cansat-tsniimash/cansat-atlaspp-2022-2023/readme.md

Репозитий команды АТЛАС++ на 2022-2023 года
