cansat-tsniimash/cansat-atlaspp-2022-2023/scheme/projects/Альфа/Alfa_b.brd

## EAGLE design scheme/projects/Альфа/Alfa_b.brd (2023-02-11)

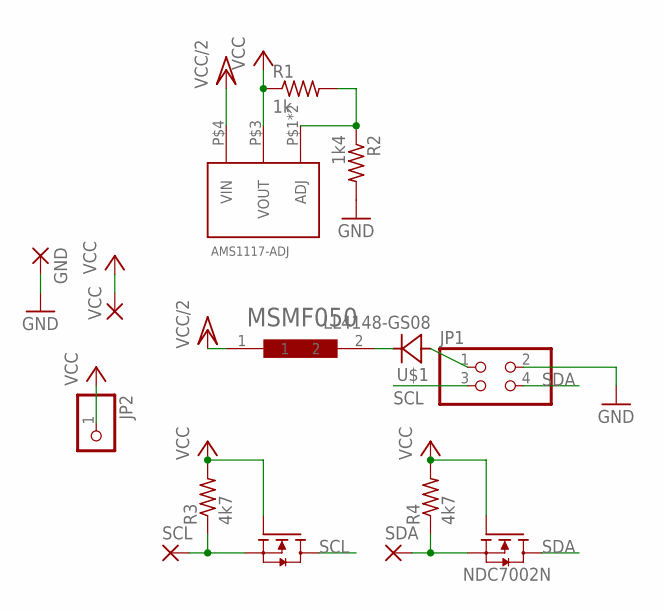
[picture p1: schematic Alfa_b.sch]

Parts:
AMS1117-ADJ: AMS1117; SOT223
GND: SMD2; SMD1,27-2,54
JP1: PINHD-2X2; 2X02
JP2: PINHD-1X1; 1X01
MSMF050: MF-MSMF050
NDC7002N: NDC7002N; SOT-23-6
R1: 1k; R0603
R2: 1k4; R0603
R3, R4: 4k7; R0603
SCL: SMD2; SMD1,27-2,54
SDA: SMD2; SMD1,27-2,54
U$1: LL4148-GS08; SOD-80
VCC: SMD2; SMD1,27-2,54

Connections:
GND: GND.1, JP1.2, R2.2
unnamed: MSMF050.2, U$1.2 (C)
unnamed: JP1.1, U$1.1 (A)
unnamed: AMS1117-ADJ.P$1 (ADJ), AMS1117-ADJ.P$2 (ADJ), R1.2, R2.1
unnamed: NDC7002N.5 (S1), R3.1, SCL.1
unnamed: NDC7002N.2 (S2), R4.1, SDA.1
SCL: JP1.3, NDC7002N.6 (D1)
SDA: JP1.4, NDC7002N.4 (D2)
VCC: AMS1117-ADJ.P$3 (VOUT), JP2.1, NDC7002N.1 (G1), NDC7002N.3 (G2), R1.1, R3.2, R4.2, VCC.1
VCC/2: AMS1117-ADJ.P$4 (VIN), MSMF050.1

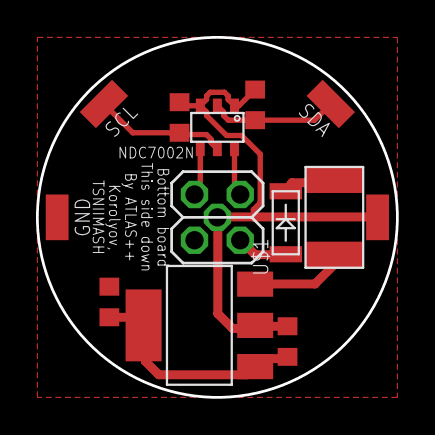
[picture p2: board Alfa_b.brd from above]

Board: 2 copper layers, 20.0 x 20.0 mm, 14 parts (1 on the bottom side), 10 nets.
