cansat-tsniimash/cansat-atlaspp-2022-2023/scheme/projects/Бета/Beta.brd

## EAGLE design scheme/projects/Бета/Beta.brd (2023-02-11)

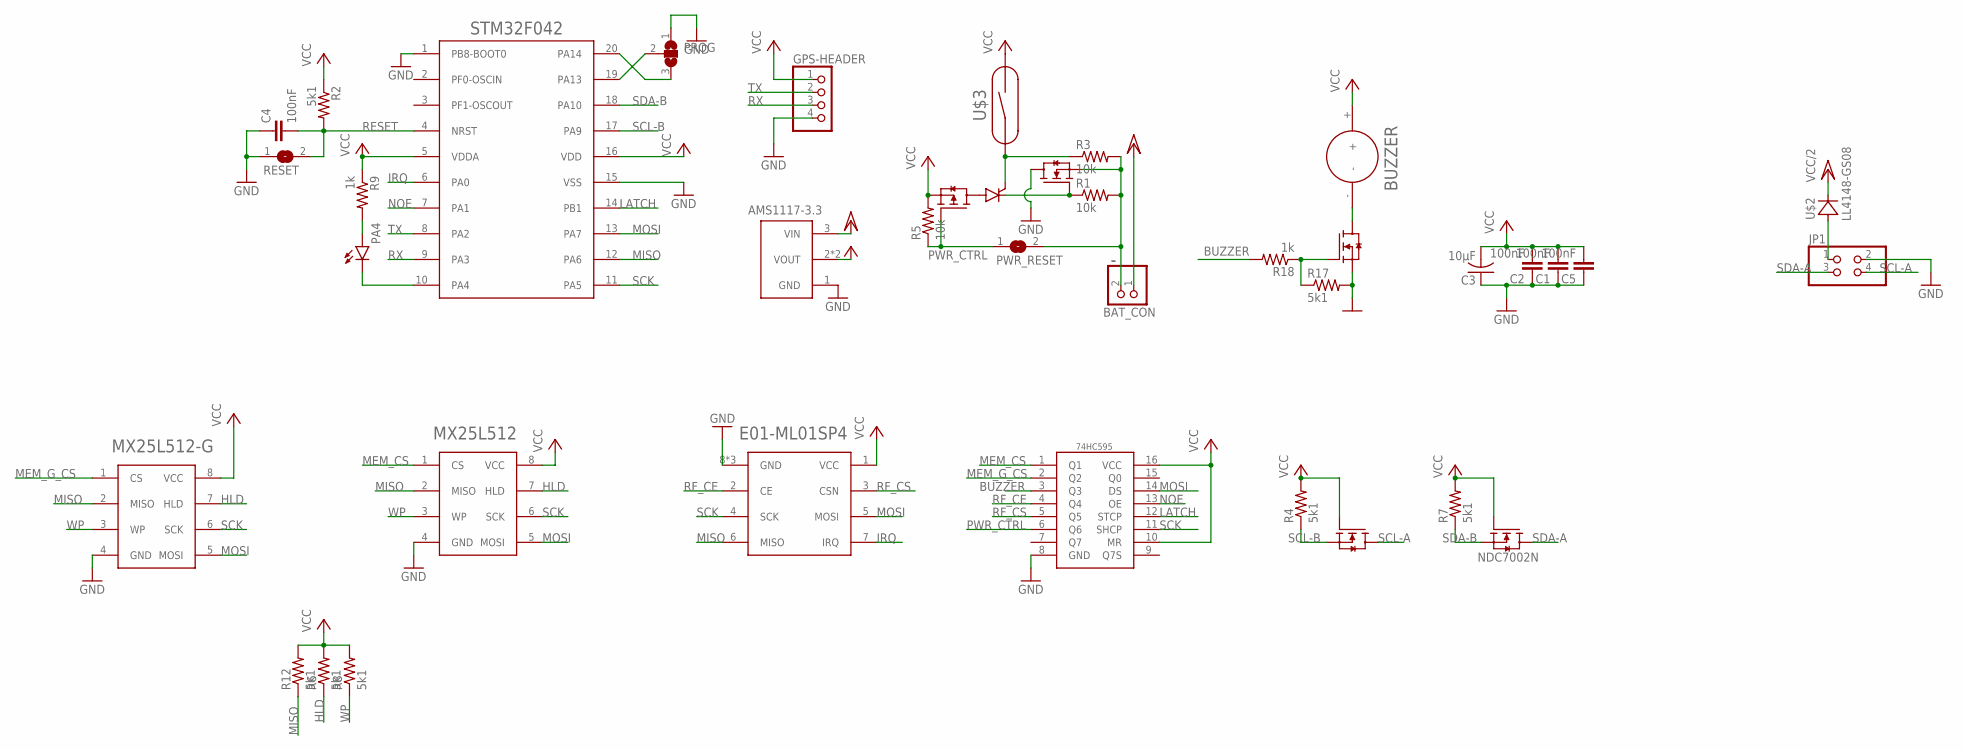
[picture p3: schematic Beta.sch]

Parts:
74HC595: 74HC595SOIC16; SOIC16
AMS1117-3.3: AMS1117; SOT223
AO3407: AO3407A; SOT23-3
BAT_CON: PINHD-1X2; 1X02
BUZ: SI2302CDS; SOT23-3
BUZZER: BUZZER-5V; BUZZER
C1, C2, C4, C5: 100nF; C0603
C3: 10µF; C1206
E01-ML01SP4: E01-ML01SP4
GPS-HEADER: PINHD-1X4; 1X04
JP1: PINHD-2X2; 2X02
MX25L512, MX25L512-G: MX25L25645; SOP8
NDC7002N: NDC7002N; SOT-23-6
P0102BL: P0102BL; SOT23-3
PA4: LEDCHIPLED_0603; CHIPLED_0603
PROG: SJ2W; SJ_2
PWR_RESET: SJ
R1, R3, R5: 10k; R0603
R2, R4, R6, R7, R8, R12, R17: 5k1; R0603
R9, R18: 1k; R0603
RESET: SJ
SI2302: SI2302CDS; SOT23-3
STM32F042: STM32F042F6P6; TSSOP-20
U$2: LL4148-GS08; SOD-80
U$3: МКА-07101

Connections:
BUZZER: 74HC595.3 (Q3), R18.2
GND: 74HC595.8 (GND), AMS1117-3.3.1 (GND), BUZ.2 (S), C1.1, C2.1, C3.1, C4.1, C5.1, E01-ML01SP4.8 (GND), E01-ML01SP4.9 (GND), E01-ML01SP4.10 (GND), GPS-HEADER.4, JP1.2, MX25L512.4 (GND), MX25L512-G.4 (GND), PROG.1, R17.2, RESET.1, SI2302.3 (D), STM32F042.1 (PB8-BOOT0), STM32F042.15 (VSS)
GND1: PA4.C, STM32F042.10 (PA4)
HLD: MX25L512.7 (HLD), MX25L512-G.7 (HLD), R6.1
IRQ: E01-ML01SP4.7 (IRQ), STM32F042.6 (PA0)
LATCH: 74HC595.12 (STCP), STM32F042.14 (PB1)
MEM_CS: 74HC595.1 (Q1), MX25L512.1 (CS)
MEM_G_CS: 74HC595.2 (Q2), MX25L512-G.1 (CS)
MISO: E01-ML01SP4.6 (MISO), MX25L512.2 (MISO), MX25L512-G.2 (MISO), R12.1, STM32F042.12 (PA6)
MOSI: 74HC595.14 (DS), E01-ML01SP4.5 (MOSI), MX25L512.5 (MOSI), MX25L512-G.5 (MOSI), STM32F042.13 (PA7)
unnamed: BUZ.3 (D), BUZZER.-
unnamed: PROG.2, STM32F042.19 (PA13)
unnamed: PROG.3, STM32F042.20 (PA14)
unnamed: P0102BL.1 (C), R1.1, SI2302.1 (G)
unnamed: PA4.A, R9.2
unnamed: P0102BL.2 (G), R3.1, U$3.1
unnamed: AO3407.3 (D), P0102BL.3 (A)
unnamed: BAT_CON.2, PWR_RESET.2, R1.2, R3.2, SI2302.2 (S)
unnamed: BUZ.1 (G), R17.1, R18.1
unnamed: JP1.1, U$2.1 (A)
NOE: 74HC595.13 (OE), STM32F042.7 (PA1)
PWR_CTRL: 74HC595.6 (Q6), AO3407.1 (G), PWR_RESET.1, R5.1
RESET: C4.2, R2.2, RESET.2, STM32F042.4 (NRST)
RF_CE: 74HC595.4 (Q4), E01-ML01SP4.2 (CE)
RF_CS: 74HC595.5 (Q5), E01-ML01SP4.3 (CSN)
RX: GPS-HEADER.3, STM32F042.9 (PA3)
SCK: 74HC595.11 (SHCP), E01-ML01SP4.4 (SCK), MX25L512.6 (SCK), MX25L512-G.6 (SCK), STM32F042.11 (PA5)
SCL-A: JP1.4, NDC7002N.6 (D1)
SCL-B: NDC7002N.5 (S1), R4.1, STM32F042.17 (PA9)
SDA-A: JP1.3, NDC7002N.4 (D2)
SDA-B: NDC7002N.2 (S2), R7.1, STM32F042.18 (PA10)
TX: GPS-HEADER.2, STM32F042.8 (PA2)
VCC: 74HC595.10 (MR), 74HC595.16 (VCC), AMS1117-3.3.2 (VOUT), AMS1117-3.3.4 (VOUT), AO3407.2 (S), BUZZER.+, C1.2, C2.2, C3.2, C5.2, E01-ML01SP4.1 (VCC), GPS-HEADER.1, MX25L512.8 (VCC), MX25L512-G.8 (VCC), NDC7002N.1 (G1), NDC7002N.3 (G2), R2.1, R4.2, R5.2, R6.2, R7.2, R8.2, R9.1, R12.2, STM32F042.5 (VDDA), STM32F042.16 (VDD), U$3.2
VCC/2: AMS1117-3.3.3 (VIN), BAT_CON.1, U$2.2 (C)
WP: MX25L512.3 (WP), MX25L512-G.3 (WP), R8.1

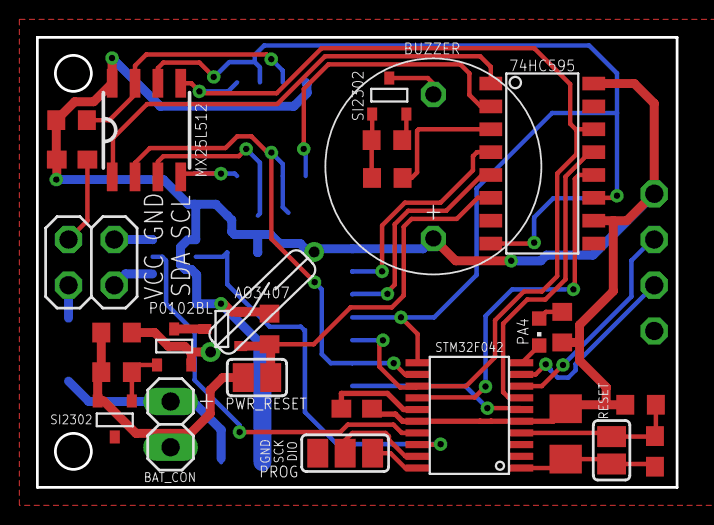
[picture p4: board Beta.brd from above]

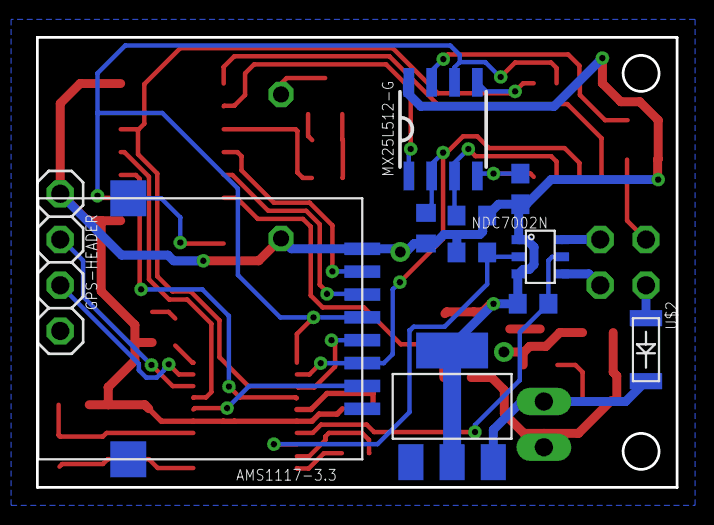
[picture p5: board Beta.brd from below]

Board: 2 copper layers, 35.5 x 25.0 mm, 38 parts (11 on the bottom side), 35 nets.
