cansat-tsniimash/cansat-atlaspp-2022-2023/scheme/projects/Альфа/Alfa_t.brd

## EAGLE design scheme/projects/Альфа/Alfa_t.brd (2023-02-11)

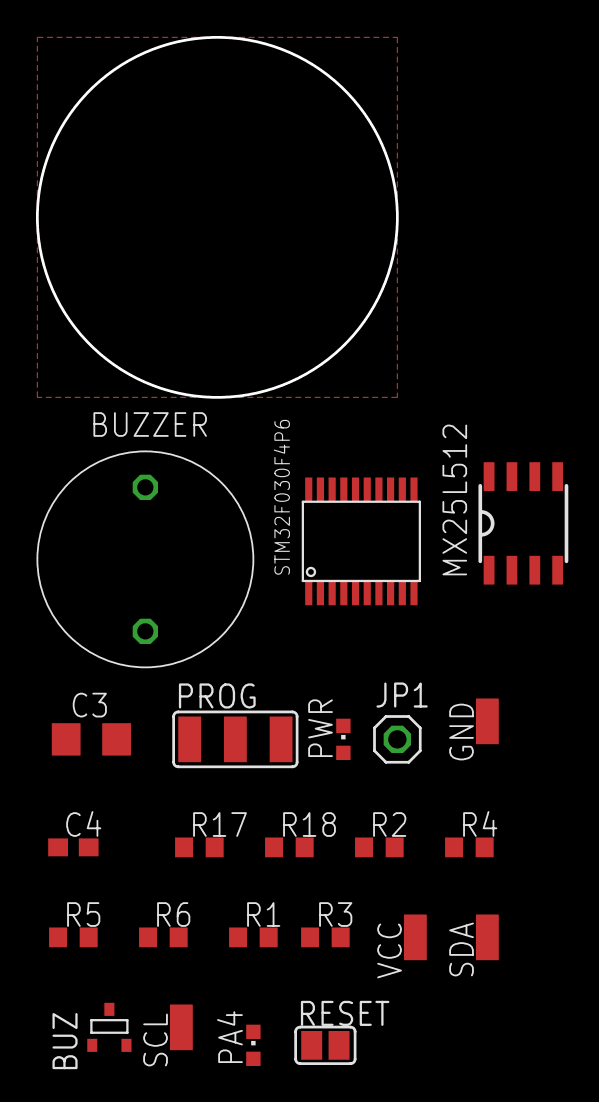
[picture p6: board Alfa_t.brd from above]

Board: 2 copper layers, 20.0 x 20.0 mm, 23 parts (0 on the bottom side), 21 nets, no tracks yet.

Parts:
BUZ: SI2302CDS; SOT23-3
BUZZER: BUZZER-5V; BUZZER
C3: 10µF; C1206
C4: 100nF; C0603
GND: SMD1,27-2,54
JP1: 1X01
MX25L512: MX25L25645; SOP8
PA4: CHIPLED_0603
PROG: SJ_2W
PWR: CHIPLED_0603
R1, R3, R18: 1k; R0603
R2, R4, R5, R6, R17: 5k1; R0603
RESET: SJ
SCL: SMD1,27-2,54
SDA: SMD1,27-2,54
STM32F030F4P6: STM32F030F4P6; TSSOP-20
VCC: SMD1,27-2,54

Connections:
BUZZER: R18.2, STM32F030F4P6.9
CS: MX25L512.1, STM32F030F4P6.14
GND: BUZ.2, C3.1, C4.1, GND.1, MX25L512.4, PROG.3, PWR.C, R17.2, RESET.1, STM32F030F4P6.1, STM32F030F4P6.15
MISO: MX25L512.2, STM32F030F4P6.12
MOSI: R4.2, STM32F030F4P6.13
unnamed: BUZ.3, BUZZER.-
unnamed: PROG.2, STM32F030F4P6.20
unnamed: PROG.1, STM32F030F4P6.19
unnamed: PWR.A, R3.2
unnamed: PA4.A, R1.2
unnamed: PA4.C, STM32F030F4P6.10
unnamed: JP1.1, STM32F030F4P6.8
unnamed: MX25L512.3, R5.1
unnamed: BUZ.1, R17.1, R18.1
unnamed: MX25L512.5, R4.1
unnamed: MX25L512.7, R6.1
RESET: C4.2, R2.2, RESET.2, STM32F030F4P6.4
SCK: MX25L512.6, STM32F030F4P6.11
SCL: SCL.1, STM32F030F4P6.17
SDA: SDA.1, STM32F030F4P6.18
VCC: BUZZER.+, C3.2, MX25L512.8, R1.1, R2.1, R3.1, R5.2, R6.2, STM32F030F4P6.5, STM32F030F4P6.16, VCC.1
