cansat-tsniimash/cansat-atlaspp-2022-2023/scheme/projects/Альфа/Alfa_m.brd

## EAGLE design scheme/projects/Альфа/Alfa_m.brd (2023-02-11)

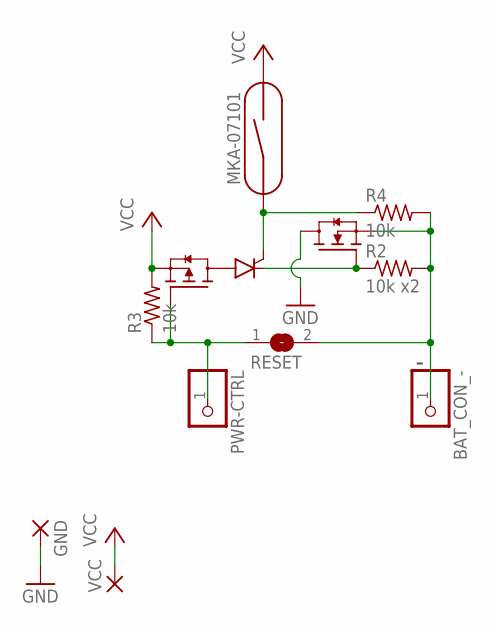
[picture p7: schematic Alfa_m.sch]

Parts:
AO3407: AO3407A; SOT23-3
BAT_CON_-: PINHD-1X1; 1X01
GND: SMD2; SMD1,27-2,54
P0102BL: P0102BL; SOT23-3
PWR-CTRL: PINHD-1X1; 1X01
R2: 10k x2; R0603
R3, R4: 10k; R0603
RESET: SJ
SI2302: SI2302CDS; SOT23-3
VCC: SMD2; SMD1,27-2,54
МКА-07101: МКА-07101

Connections:
GND: GND.1, SI2302.3 (D)
unnamed: P0102BL.1 (C), R2.1, SI2302.1 (G)
unnamed: P0102BL.2 (G), R4.1, МКА-07101.1
unnamed: AO3407.3 (D), P0102BL.3 (A)
unnamed: BAT_CON_-.1, R2.2, R4.2, RESET.2, SI2302.2 (S)
unnamed: AO3407.1 (G), PWR-CTRL.1, R3.1, RESET.1
VCC: AO3407.2 (S), R3.2, VCC.1, МКА-07101.2

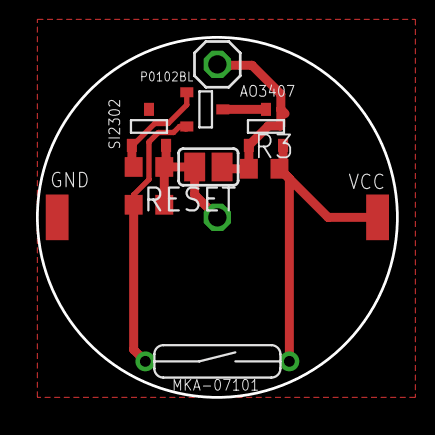
[picture p8: board Alfa_m.brd from above]

Board: 2 copper layers, 20.0 x 20.0 mm, 12 parts (1 on the bottom side), 7 nets.
