cansat-tsniimash/cansat-atlaspp-2022-2023/src/board/Cerberus/Cerberus.ioc

Mcu.UserName=STM32F401RCTx
PA13.Signal=SYS_JTMS-SWDIO
PA14.Signal=SYS_JTCK-SWCLK
PA4.Signal=ADCx_IN4
PA5.Signal=GPIO_Input
PB13.Signal=SPI2_SCK
PB14.Signal=SPI2_MISO
PB15.Signal=SPI2_MOSI
PB6.Signal=I2C1_SCL
PB7.Signal=I2C1_SDA
PC1.GPIO_Label=latch
PC1.Signal=GPIO_Output
PC10.Signal=SDIO_D2
PC11.Signal=SDIO_D3
PC12.Signal=SDIO_CK
PC13-ANTI_TAMP.GPIO_Label=oe
PC13-ANTI_TAMP.Signal=GPIO_Output
PC14-OSC32_IN.Signal=RCC_OSC32_IN
PC15-OSC32_OUT.Signal=RCC_OSC32_OUT
PC2.Signal=GPIO_Input
PC4.Signal=GPIO_Output
PC5.Signal=GPIO_Output
PC6.Signal=USART6_TX
PC7.Signal=USART6_RX
PC8.Signal=SDIO_D0
PC9.Signal=SDIO_D1
PD2.Signal=SDIO_CMD
