cansat-tsniimash/cansat-atlaspp-2022-2023/src/board/Cerberus/Core/Inc/main.h

#define oe_Pin GPIO_PIN_13
#define oe_GPIO_Port GPIOC
#define latch_Pin GPIO_PIN_1
#define latch_GPIO_Port GPIOC
