cansat-tsniimash/cansat-atlaspp-2022-2023/(commit log)

2022-11-12 Начинаем
2022-11-12 Добавил метаданные в гитигнор
2022-11-12 Create empty project, add to ignore: .settings and Debug/ /Создал пустой проэкт, добавил в игнор: .settings and Debug
2022-11-12 Создал пустой проекта для теста I2C Slave
2022-11-12 Костыли для i2c. Будем тестить
2022-11-12 Прописали в костыль конкретные пины/ /Wrote specific pins to crutch
2022-11-12 Прописал конкретные пины
2022-11-12 Написал приём байта по I2C
2022-11-12 Написал отправку байта по I2C/ /Wrote byte sending using I2C
2022-11-19 Добавил структуру, поменял отправляемое значение, наладил отправку/ /Added struct, change the sent value, adjusted sending
2023-02-11 платы
    [Alfa_b.brd, Alfa_b.sch, Alfa_m.brd, Alfa_m.sch, Alfa_t.brd, Alfa_t.sch, Beta.brd, Beta.sch]
2023-02-11 Добавил задержку в 100мс/ /Added delay 100ms
2023-02-11 Дописал приём
2023-02-11 Заменил массив на структуру
2023-02-11 Добавила сабмодуль с библиотекой
2023-02-11 создал проэкт, добавил измерения давления тмпературы влажности и высоты
2023-02-11 Добавил гироскоп и акселерометр
2023-02-11 Добавил магнитометр по LIS
2023-02-11 Добавлены фоторезистор и DS18, DS18 не работает
2023-02-11 Приемка-наземка на петухоне
2023-02-18 Написал код для получения чего-то по радио
2023-02-18 Написал код для отправки чего-то по радио
2023-02-18 Код для радио
2023-02-18 Добавил отправку на sd
2023-02-22 Дописал Test_I2C, вроде норм
2023-03-03 Написал в цикле проверку на ошибки I2C.
2023-03-04 Начал переписывать флаги в its-i2c-link
2023-03-10 Задебажил ашипки(остались только флаги!)
2023-03-10 Хэдэры которые проспали
2023-03-11 Код для теста i2c на аппарат
2023-03-11 ничего не сделал
2023-03-11 Теперь это вроде собирается
2023-03-11 чета вроде сделал
2023-03-11 еще чета
2023-03-17 Запущен i2c-link (на новой cube-ide, поэтому требует правок)
2023-03-17 статус заполнил и чета с сд сделал но оно не работает
2023-03-18 Написал подчинённую часть I2C | БЕТА
2023-03-22 Приготовились к тестам
2023-03-25 Настройка СД
2023-03-25 я жеска сделал сд оно работает
2023-03-25 я супер мега жеска сделал сд и оно супер мега круто работает дайте денег
2023-03-25 Супер ультра мега гелекси жеска сделал так чтоб дс до десятых было
2023-03-27 Заигнорил лишнее
2023-03-27 Сихнронизация сабмодуля
2023-03-27 Сборка новой cubeide (+ добавление забытых генерированных файлов)
2023-03-27 Все работает
2023-03-29 Передача работает, идём проверять дальше(типо уверенно, спасити(()
2023-03-29 самая жеская отправка по ай ту си 1 2 пол третьей и четвертая комманды сделаны
2023-03-29 Перенесли While, продолжаем тестить
2023-03-31 сделал самые жеские в мире состояния и там лампочки мигают по кайфу а еще сд в хард фолт не гг
2023-04-01 Написали функцию рид
2023-04-01 ПРОШЛЫЙ КОММИТ НЕ МОЙ Я ДЕЛАЮ ТОЛЬКО НОРМАЛЬНЫЕ КОММИТЫ ЭТО ПЕРВО АПРЕЛЬСКАЯ ШУТКА Сделал самую жескю функцию рид но там чета не работает дальше лень
2023-04-05 жеска добавили ожидание
2023-04-05 Забыл заполнить csv_file.h, но не забыл перенести структуры в отдельный хэдр + добавил запись в csv файлы
2023-04-07 я самый жеский и сделал проверку жускую там все пишет вообще класс(прошлый коммит не мой)
2023-04-07 Перегенерировал код
2023-04-08 Подправил запись цсв
2023-04-14 Наладили работу в режиме слейва на I2C:
    1. Выключили SlaveByteControl;
    2. Обработку ADDR флагов перенесли после стопов, так как они влетают
    похоже одновременно;
    3. Добавили чистку TX регистра после внезапных остановок DMA
2023-04-22 Начали тестить, СР работает, но время на костылях. Радио потестить не удалось, возможен конфликт с СР
2023-04-28 Дописали и потестили радио на ЧЯ
2023-04-28 Начали переписывать команды i2c на ОА
2023-04-28 покайфу написал ай ту си супер мега жеска
2023-04-29 Начал переписывать протокол I2C
2023-04-29 Предпринята попытка завести память
2023-04-29 Радио работает
2023-05-03 Недостающие файлы
2023-05-03 Починила проект
2023-05-12 САМАЯ ЖЕСКАЯ ДЖИПИЭСКА ПАЧАЛА ПРИНИМАТЬ НОРМАЛЬНО КАЙФ ЭЩКЕРЕЕЕЕЕЕ
2023-05-12 Недостающие файлы библиотек
2023-05-17 чутка дописал I2C погода сегодня хорошая, только ветерок ай-ай
2023-05-17 Парсер для Беты ветерок ай-ай
2023-05-17 проверка путей(
2023-05-19 навсякий перед пуллом
2023-05-20 Самая жеская гамма в мире эщкере
2023-05-20 Правки гаммы для сборки + библиотека
2023-05-24 изменили настройки радио и расскомитил что закомитили
2023-05-24 Сделал структуру для настроек передаваемых с ОА (у меня сегодня шторы)
2023-05-27 Жеска засолил гамму
2023-05-27 Самая жеская связь по i2c с ЧОРНИМИ ящиками
2023-05-31 Тестим i2c
2023-05-31 Альфа
2023-05-31 Проверили протокол общения ЧЯ по i2c
2023-06-02 Сделал самую жескую чета там с циклограммой все отправляется с оа на чя ЭЩКЕРЕЕЕЕ
2023-06-02 Сделал жескую отправку покета по радио с ЧОРного ящика ЭЩКЕРЕЕЕЕЕ
2023-06-03 Сделал CSV парсер для ОА и Беты + страые правки приемника беты Я КОМИЧУ ЧЕРЕЗ ТЕРМИНАЛ НА ЛИНУКСЕ)
2023-06-03 Жеска засолил гамму ЭЩКЕРЕЕЕЕ
2023-06-03 Жеска подфиксил бету
2023-06-03 ЖЕСКА ЗАСОЛИЛ 3ИЕ УСТРОЙСТВО ЭЩКЕРЕЕЕЕЕЕ(чета не работает)
2023-06-07 ИСправления для СД карты
2023-06-07 Жеска добавил 3 файла для бетты гаммы и обычный хз че это Let's get it
2023-06-09 ЖЕСКА ДОСОЛИЛ 3ИЕ УСТРОЙСТВО ЭЩКЕРЕЕЕЕЕЕЕ = LET'S GET IT
2023-06-10 Альфа пуш мега прощаюсь с виндовс ((
2023-06-10 Флаги короче сделали как Василий сказал
2023-06-12 Изменения в проектах по результатам тестов плат. Код с тестовым циклом
2023-06-13 Очередные тесты плат. все по отдельности работает
2023-06-14 ТЕПЕРЬ 6ТИ СЛОТОВОЕ 3ИЕ УСТРОЙСТВО ИДЕТ СНОСИТЬ ВАМ ТРОН
2023-06-24 Добавлены функции проверки радобоспособности, сигналы светодиодом и пищалкой
2023-06-24 Проверили радио, поменяли длинну времени для всех пакетов
2023-06-24 Поменяли настройки(как в ПЗ), написали красивенькие состояния, поправили все
2023-06-24 Подогнал под новую версию
2023-06-27 Заводим i2c
2023-06-28 Написал состояния Альфы, Беты, Гаммы, MOUNT(SD)
2023-06-28 Жеска напИсали проверку ай2си ЧЯ и адресацию на альфе ЭЩКЕРЕЕЕЕЕЕ fix
    [Cerberus.ioc, app_main.c, bb.c, bb.h]
2023-06-28 fix alpha beta gamma
    [app_main.c]
2023-06-30 кайф жеский по памяти
2023-06-30 fix чета память кайф
    [app_main.c, mem-proxy.c]
2023-07-01 КАЙA КОНКРЕТНЫЙ ЭЩКЕРЕЕЕЕЕЕЕЕЕЕЕ ЮХУУУУУ fix
    [Cerberus.ioc, app_main.c, bb.c, main.h]
2023-07-03 эталонные данные с ОА, с радио закину завтра
    [packet1.csv, packet2.csv, packet3.csv, packet4.csv]
2023-11-04 Еще правки
2023-11-04 Какие-то изменения
